AlexanderOsharov/PredProf-2024/schemes/8.jpg

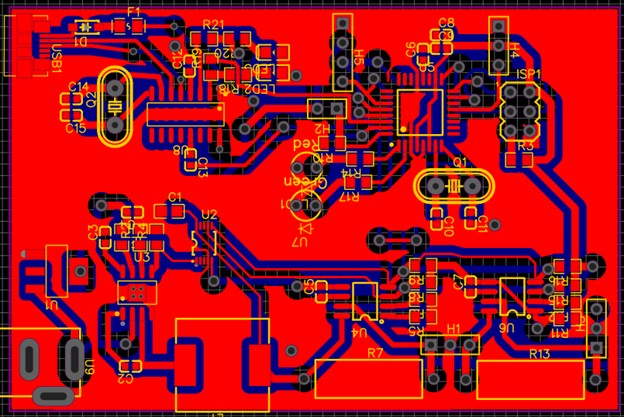
schemes/8.jpg
