AlexanderOsharov/PredProf-2024/schemes/2.jpg

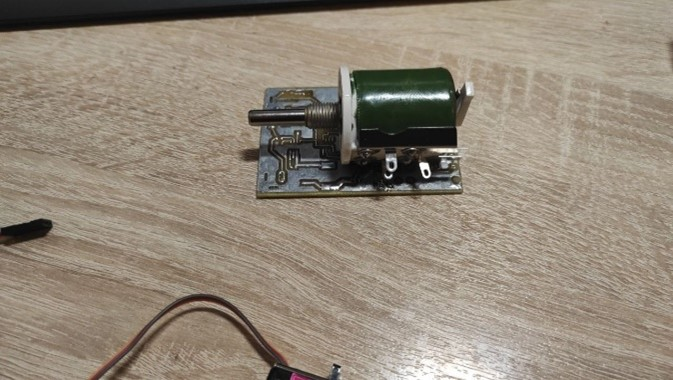
schemes/2.jpg
