AlexanderOsharov/PredProf-2024/README.md

# Проект "Параметрический контроль микросхем"

## О команде "Серьёзные ребята"
Наша команда участвует в проекте "Параметрический контроль микросхем", который посвящен созданию отказоустойчивого устройства. В нее входят следующие участники:
- Дидковский Илья - капитан
- Калашников Дмитрий - исследователь данных
- Клячин Иван - разработчик 3D моделей
- Мелешкин Кирилл - программист
- Ошаров Александр - экономист, занимающийся сметой и схемами

## Содержание

1. [Документация](https://github.com/AlexanderOsharov/PredProf-2024-/tree/main/documentation)
2. [Видео](https://github.com/AlexanderOsharov/PredProf-2024-/tree/main/video)
3. [3D Модель](https://github.com/AlexanderOsharov/PredProf-2024-/tree/main/3d_model)
4. [Схемы](https://github.com/AlexanderOsharov/PredProf-2024-/tree/main/schemes)
5. [Смета](https://github.com/AlexanderOsharov/PredProf-2024-/tree/main/estimates)
6. [Код](https://github.com/AlexanderOsharov/PredProf-2024/tree/main/code)
