AlexanderOsharov/PredProf-2024/video/README.md

Ссылка на полноформатное (308 Мб) видео. В этом каталоге находится сжатое (51,3 Мб).
Ссылка: 
[https://1drv.ms/v/s!AjlyOsqZFbYNud4ulOwQ5qmgsg5Rlg?e=nLBx9l](https://1drv.ms/v/s!AjlyOsqZFbYNud4ulOwQ5qmgsg5Rlg?e=nLBx9l)
