AlexanderOsharov/PredProf-2024/schemes/1.jpg

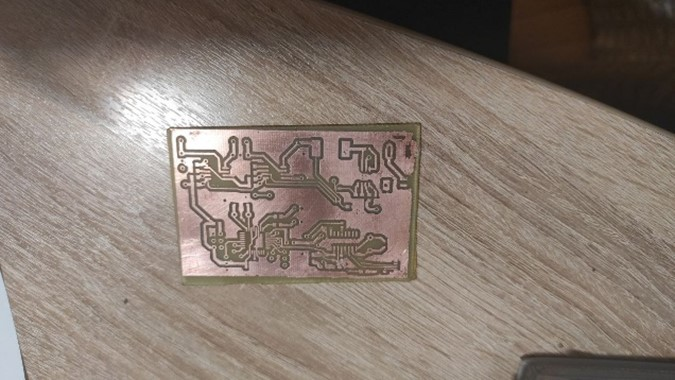
schemes/1.jpg
