AlexanderOsharov/PredProf-2024/schemes/3.jpg

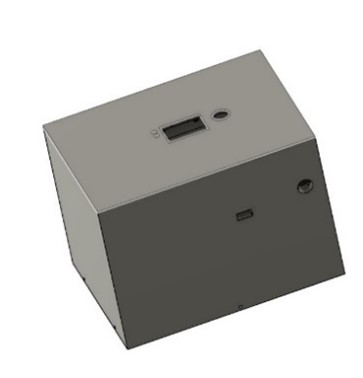
schemes/3.jpg
