AlexanderOsharov/PredProf-2024/schemes/4.jpeg

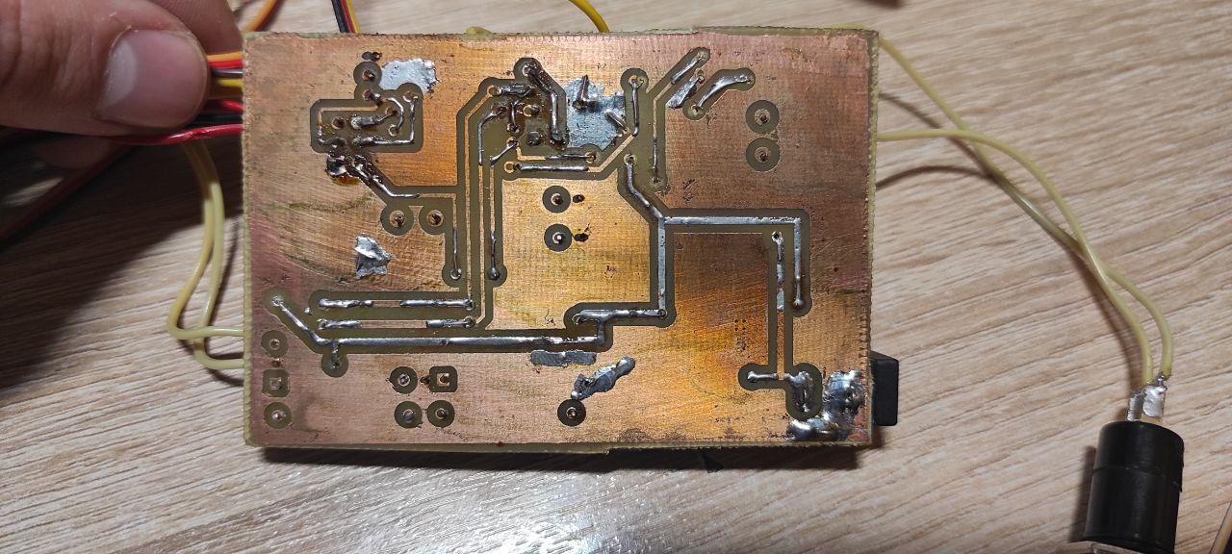
schemes/4.jpeg
