AlexanderOsharov/PredProf-2024/schemes/5.jpeg

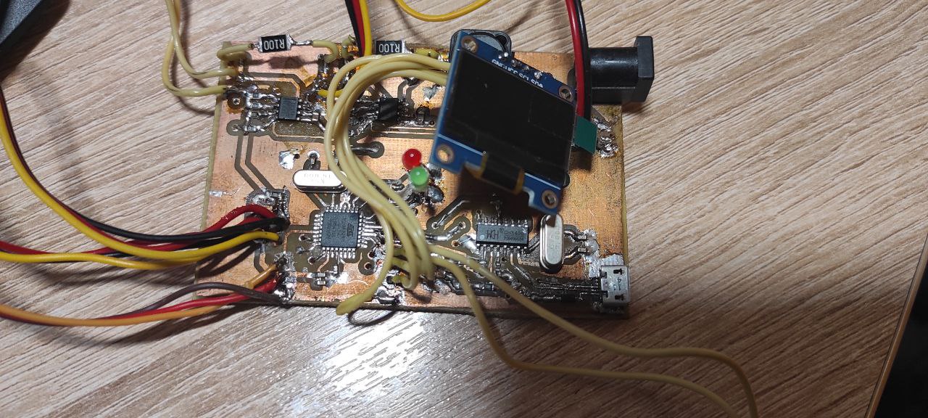
schemes/5.jpeg
