AlexanderOsharov/PredProf-2024/schemes/6.jpeg

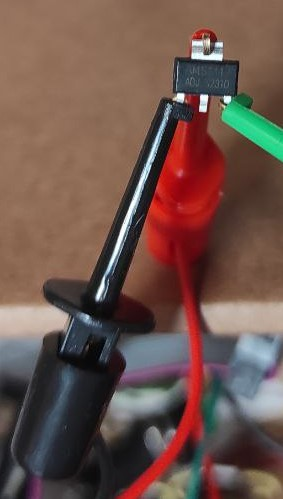
schemes/6.jpeg
