AlexanderOsharov/PredProf-2024/schemes/7.jpeg

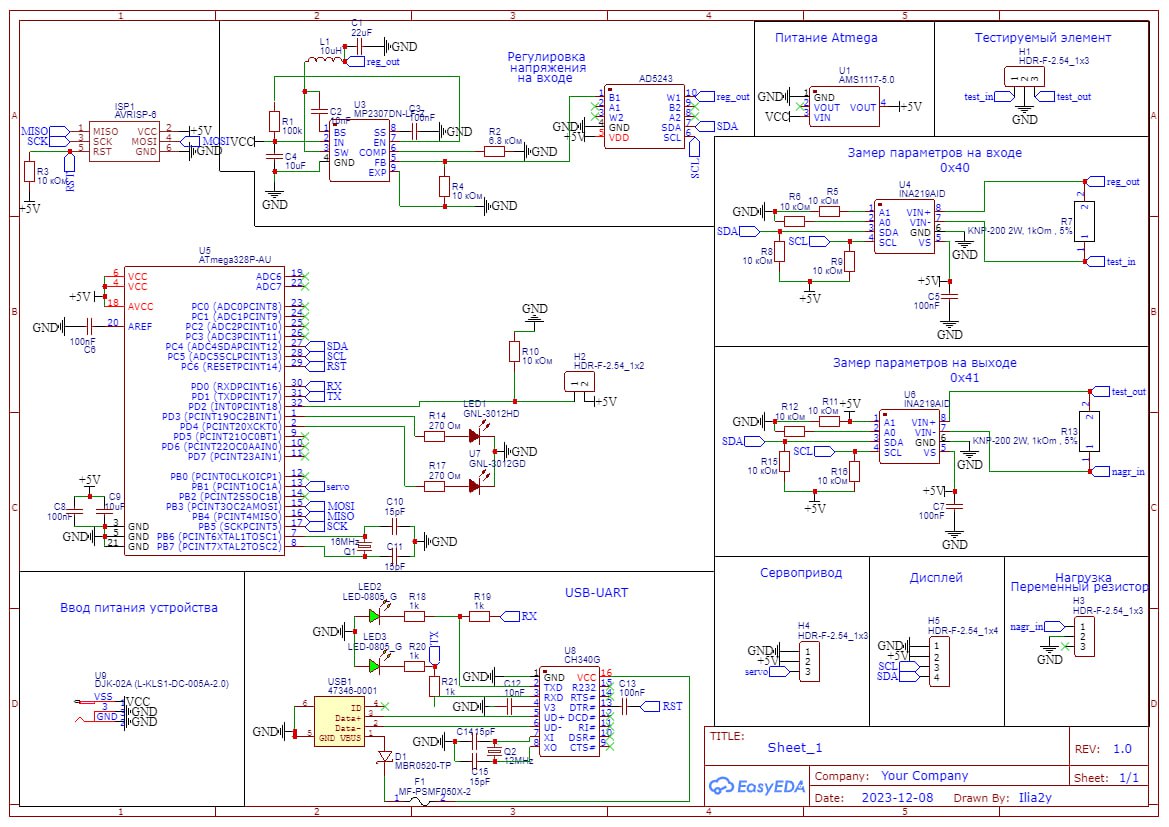
schemes/7.jpeg
