AlexanderOsharov/PredProf-2024/schemes/9.png

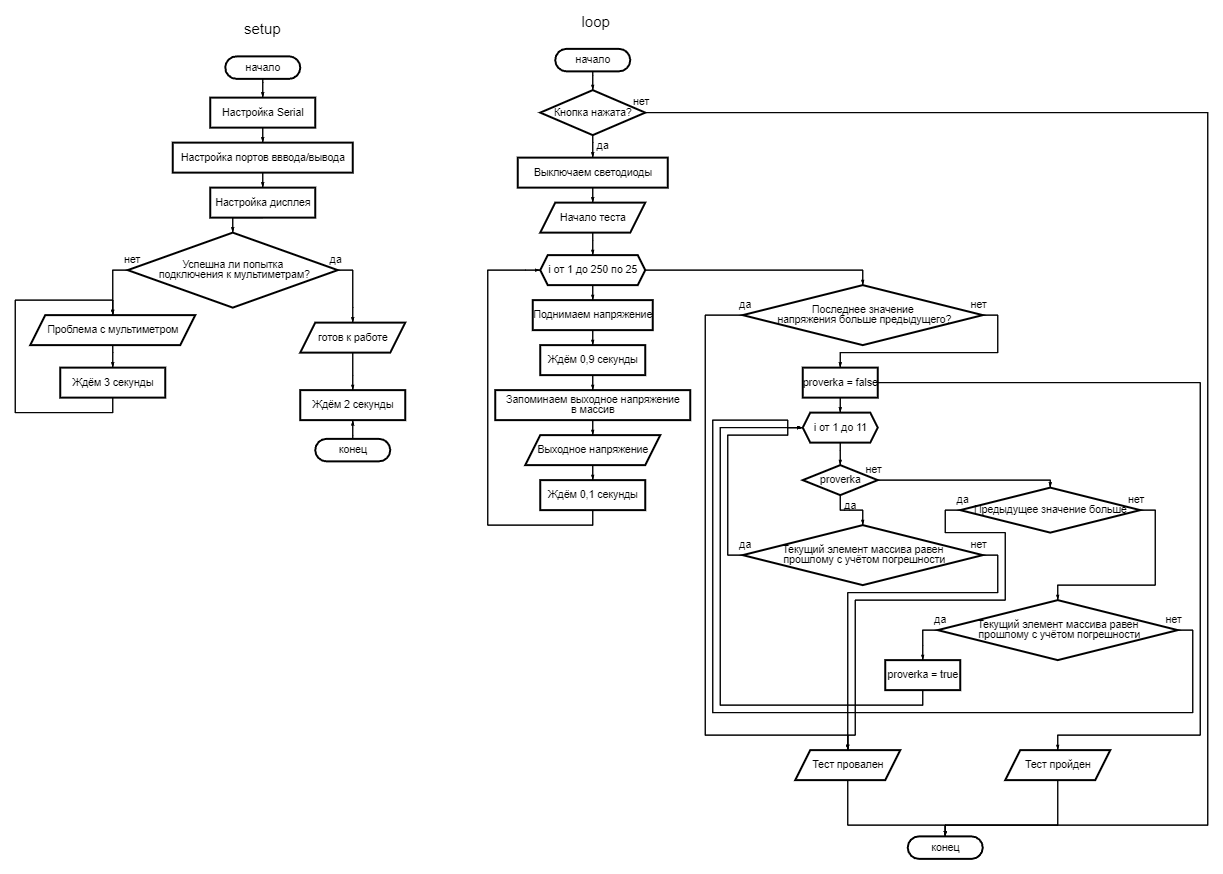
schemes/9.png
