AlexanderOsharov/PredProf-2024/estimates/Компоненты смета.xlsx

ID | Name | Designator | Footprint | Quantity | Name | Ссылка на компонент | Примечание | Фактическая стоимость, руб (с НДС) | Срок поставки | Примечание 2
1 | 15pF | C1,C2 | C0603 | 2 | конденсатор | https://www.chipdip.ru/product/grm1885c2a150j |  | 70 | доставлено
2 | 100nF | C3,C4,C6,C7,C9, C12 | C0603 | 6 | конденсатор | https://www.chipdip.ru/product/grm188r71c104ka01d |  | 60 | доставлено
3 | 10uF | C5, C16 | C0603 | 2 | конденсатор | https://www.chipdip.ru/product/grm188r60j106me47d |  | 180 | доставлено
4 | 10nF | C8,C10,C11,C15 | C0603 | 4 | конденсатор | https://www.chipdip.ru/product/grm188r72a103ka01d |  | 70 | доставлено
5 | 22uF | C14 | C0805 | 1 | конденсатор | https://market.yandex.ru/product--kondensator-smd-murata-grm21br60j226me39l-kondensator-keramicheskii-22mkf-6-3v-x5r-20p-smd-0805-1sht/102019552999?sku=102019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 | Яндекс > рынок | 23 | доставлено | Закуплен на МР корректировка цены, Яндекс вернул деньги
6 | MBR0520-TP | D1 | SOD-123_L2.7-W1.6-LS3.7-RD-1 | 1 | MBR0520-TP | https://www.chipdip.ru/product/mbr0520-tp-reel-3000 |  | 8 | доставлено
7 | 10uH | L1 | IND-SMD_L12.0-W12.0 | 1 | CDRH127/LDNP-100MC | https://www.chipdip.ru/product0/8017846129 |  | 130 | 2024-01-11
8 | LED-0805_G | LED1,LED3 | LED0805_GREEN | 2 | LED-0805_G | https://www.chipdip.ru/product0/8010041020 | ЧипДип > рынок | 22 | доставлено | Закуплен на МР корректировка цены, Отправлен запрос на возврат ЧД 1заказ
9 | GNL-3012HD | LED2 | LED GNL-3012HD | 1 | GNL-3012HD | https://www.chipdip.ru/product/gnl-3012hd |  | 12 | доставлено
10 | 16MHz | Q1 | HC49S | 1 | 16MHz | https://www.zip-2002.ru/product/hc49s-16-000mhz-20pf_strong/ | Магазин ЗИП от 1000 руб, замена на ЧИПДИП | 80 | 2024-01-11
11 | 12MHz | Q3 | HC49S | 1 | 12MHz | https://www.chipdip.ru/product0/8010026034 |  | 80 | 2024-01-11
12 | 270 Ом | R1,R2 | R0805 | 2 | резистор | https://www.chipdip.ru/product/0.125w-0805-270-om-1 |  | 120 | доставлено
13 | 10 кОм | R3,R5,R6,R7,R8,R10,R11,R12,R13,R20 | R0805 | 10 | резистор | https://www.chipdip.ru/product/0.125w-0805-10-kom-1 |  | 120 | доставлено
14 | KNP-200 2W, 1kOm , 5% | R4,R9 | KNP-200 | 2 | резистор | https://www.chipdip.ru/product0/8014871442 | ЧипДип > рынок | 38 | доставлено | Закуплен на МР корректировка цены, Отправлен запрос на возврат ЧД 1заказ
15 | 1k | R14,R15,R16,R17 | R0805 | 4 | резистор | https://www.chipdip.ru/product/0.125w-0805-1-kom-1 |  | 120 | доставлено
16 | 100k | R18 | R0805 | 1 | резистор | https://www.chipdip.ru/product/0.125w-0805-100-kom-1 |  | 120 | доставлено
17 | 6.8 кОм | R19 | R0805 | 1 | резистор | https://www.chipdip.ru/product/0.125w-0805-6.8-kom-1 |  | 120 | доставлено
18 | ATMEGA328PB-AU | U1 | TQFP-32_L7.0-W7.0-P0.80-LS9.0-BL | 1 | ATMEGA328PB-AU | https://tmelectronics.ru/product/ATMEGA328PB-AU/ | TM Электроникс - доставка от месяца, замена на ЧИПДИП | 630 | доставлено
19 | AMS1117-5.0 | U2 | SOT-223_L6.5-W3.5-P2.30-LS7.0-BR | 1 | AMS1117-5.0 | https://www.chipdip.ru/product/ams1117-5.0 |  | 27 | доставлено
20 | GNL-3012GD | U3 | LED GNL-3012GD | 1 | GNL-3012GD | https://www.chipdip.ru/product/gnl-3012gd-green |  | 12 | доставлено
21 | INA219AIDCNR | U4,U6 | SOT-23-8_L3.0-W1.7-P0.65-LS2.8-BR | 2 | INA219AIDCNR | https://www.chipdip.ru/product0/8000835323 | ЧипДип > Озон | 489 | доставлено | корректировка цены, ЧД1 - 340 руб возврат оформлен; ЧД2 - 480 руб Отправлен запрос на возврат
22 | DJK-02A (L-KLS1-DC-005A-2.0) | U5 | DJK-02A (L-KLS1-DC-005A-2.0) | 1 | DJK-02A (L-KLS1-DC-005A-2.0) | https://www.chipdip.ru/product/djk-02a-l-kls1-dc-005a-2.0 |  | 19 | доставлено
23 | CH340G | U7 | SOIC-16_L9.9-W3.9-P1.27-LS6.0-BL | 1 | CH340G | https://www.chipdip.ru/product0/9000890746 |  | 74 | доставлено
24 | MP2307DN-LF-Z | U8 | SOP-8_L4.9-W3.9-P1.27-LS6.0-BL-EP | 1 | MP2307DN-LF-Z | https://www.chipdip.ru/product/mp2307dn |  | 270 | доставлено
25 | AD8400ARZ100-REEL | U9 | SOIC-8_L4.9-W3.9-P1.27-LS6.0-BL | 1 | AD8400ARZ100-REEL | https://www.chipdip.ru/product/ad8400arz100 |  | 540 | доставлено
26 | 47346-0001 | USB1 | MICRO-USB-SMD_47346-0001 | 1 | 47346-0001 | https://www.chipdip.ru/product/molex-47346-0001 |  | 140 | доставлено
27 | OLED экран | 0 | 0 | 1 | OLED экран | https://www.ozon.ru/product/oled-0-96-displey-128x64-i2c-4-pin-monohromnyy-belyy-738407664/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 |  | 306 | доставлено
28 | Резистор ППБ-25Г 2,2 КОМ | 0 | 0 | 1 | Резистор ППБ-25Г 2,2 КОМ | https://market.yandex.ru/product--rezistor-ppb-25g-2-2-kom/31605122?sku=102535224072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 | Яндекс > рынок | 300 | доставлено | корректировка цены, Яндекс - средства возвращены
29 | AMS1117-ADJ, 1А | 0 | 0 | 4 | Линейный регулятор | https://www.chipdip.ru/product/ams1117-adj-umw |  | 9 | доставлено | корректировка цены, Забираем 1 шт из 4, Отправлен запрос на возврат ЧД 1 заказ
30 | Кнопка | 0 | 0 | 1 | Кнопка | https://www.zip-2002.ru/product/pbs-11b_off-on_zelenyiy/ | Магазин ЗИП от 1000 руб, замена на ЧИПДИП | 55 | доставлено
31 | Серва | 0 | 0 | 1 | Серва | https://www.ozon.ru/product/1-sht-servoprivod-mg90s-micro-servo-servomotor-mg90s-3-7-2v-ampertok-tower-pro-mg90-180-micro-823800100/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 |  | 242 | доставлено
32 | AMS1117-1.8, 1А, 1.8В |  |  | 1 | Линейный регулятор | Чип и Дип ссылка | 09.01.24 дозаказ засчет позиции 29 | 10 | доставлено
33 | AMS1117-3.3, 1А, 3.3В |  |  | 1 | Линейный регулятор | Чип и Дип ссылка | 09.01.24 дозаказ засчет позиции 29 | 10 | доставлено
34 | AMS1117-5.0, 1А, 5В |  |  | 1 | Линейный регулятор | Чип и Дип ссылка | 09.01.24 дозаказ засчет позиции 29 | 10 | доставлено
Подсчет
ИТОГО
 |  |  |  |  |  |  | Оплачено = | 4516 | руб
