AlexanderOsharov/PredProf-2024/3d_model/body v1.obj

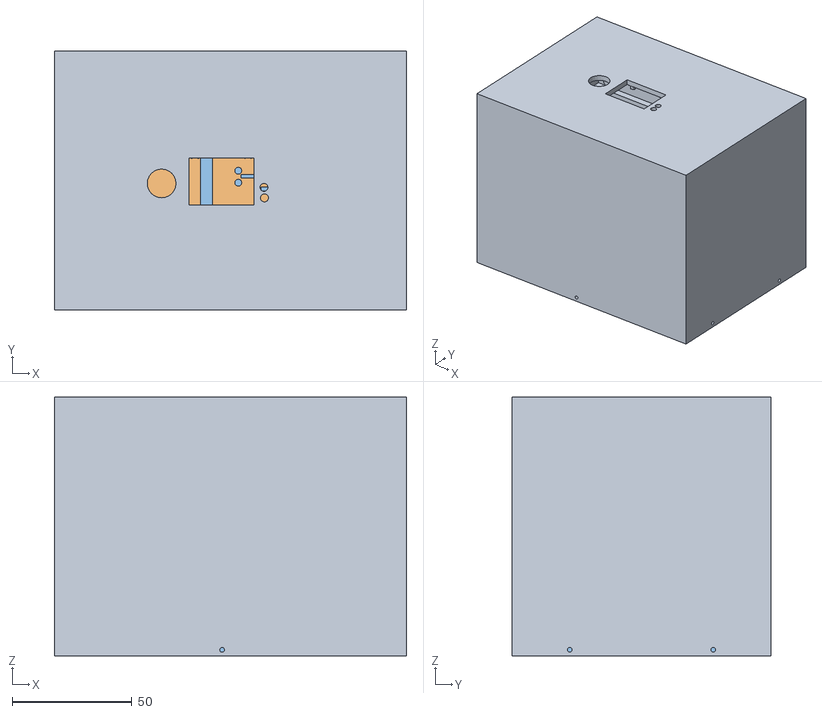
[picture p10: CAD file, 2024-02-10]
3d_model/body v1.obj
147.0 x 108.0 x 108.0
